RocketsAndRadio/WoodBadgeLEDFlasher/Circuit/Wood Badge circuit.kicad_pcb

## KiCad design Circuit/Wood Badge circuit.kicad_pcb (2024-11-16)

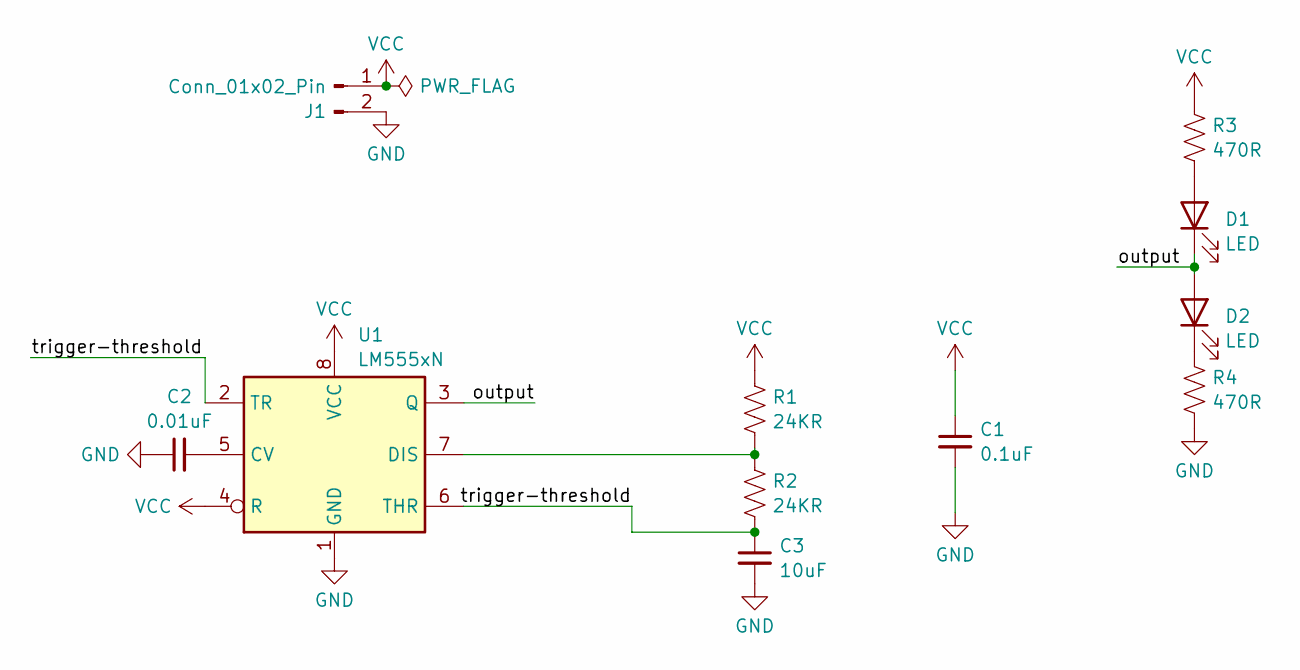
[picture p1: schematic Wood Badge circuit.kicad_sch, LED Flasher]

Parts:
C1: 0.1uF; CP_Radial_D5.0mm_P2.50mm
C2: 0.01uF; CP_Radial_D5.0mm_P2.50mm
C3: 10uF; CP_Radial_D5.0mm_P2.50mm
D1, D2: LED; LED_D5.0mm_Clear
J1: Conn_01x02_Pin; SolderWire-0.1sqmm_1x02_P3.6mm_D0.4mm_OD1mm
R1, R2: 24KR; R_Axial_DIN0411_L9.9mm_D3.6mm_P15.24mm_Horizontal
R3, R4: 470R; R_Axial_DIN0411_L9.9mm_D3.6mm_P15.24mm_Horizontal
U1: LM555xN; DIP-8_W7.62mm

Connections:
/output: D1.1 (K), D2.2 (A), U1.3 (Q)
/trigger-threshold: C3.1, R2.2, U1.2 (TR), U1.6 (THR)
GND: C1.2, C2.1, C3.2, J1.2, R4.2, U1.1 (GND)
unnamed: D1.2 (A), R3.2
unnamed: D2.1 (K), R4.1
unnamed: C2.2, U1.5 (CV)
unnamed: R1.2, R2.1, U1.7 (DIS)
VCC: C1.1, J1.1, R1.1, R3.1, U1.4 (R), U1.8 (VCC)

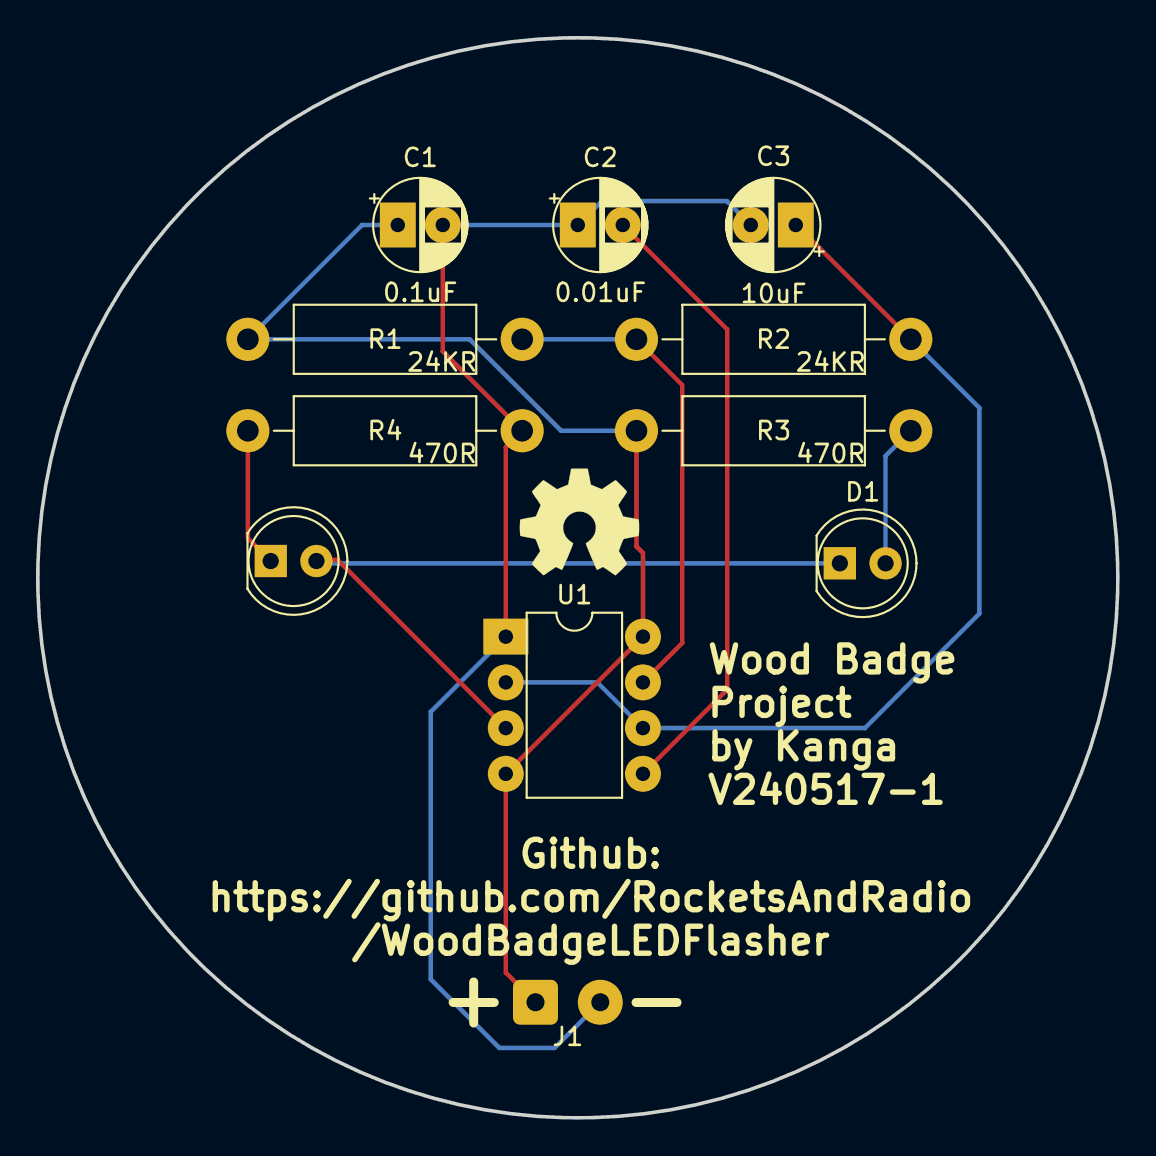
[picture p2: board Wood Badge circuit.kicad_pcb from above]

Board: 2 copper layers, 60.0 x 60.0 mm, 11 parts (0 on the bottom side), 8 nets.
