RocketsAndRadio/WoodBadgeLEDFlasher/(commit log)

2024-03-23 Finished circuit. Submitted this desgin to PCBWay
    [Wood Badge circuit.kicad_pcb, Wood Badge circuit.kicad_sch]
2024-03-30 Conversion to Kicad 8.0
    [Wood Badge circuit.kicad_pcb, Wood Badge circuit.kicad_sch]
2024-04-23 Added C3 (below R1, R2 oops) Added values of components to reach a 2Hz frequency
    [Wood Badge circuit.kicad_pcb, Wood Badge circuit.kicad_sch]
2024-06-05 Amendments to reflect fixes for faults identified in the first time the circuit was put together, such as adding capacitor C3.
    [Wood Badge circuit.kicad_pcb]
2024-11-16 Added: + and - on the solar panel connection LED outline to show where the 'flat edge' needs to go
    [Wood Badge circuit.kicad_pcb]
